chujianlee/git/平衡标定与升降调试指南.md

# 驭风轮足机器人：平衡标定与升降调试指南

固件工程：`D:\download\智能小车项目\robotcat-firmware`
串口：115200，8N1；烧录口随插拔变化（目前是 COM5，CH340）

## 固件结构（2026-10-11 重构后）

原来 800 行全堆在 `main.cpp`，现在按职责拆开：

| 文件 | 职责 |
| --- | --- |
| `src/main.cpp` | 硬件实例定义、`setup()` 初始化、主循环调度、Web/电压检测 |
| `src/balance.cpp` | 平衡环（4 路 P 控制）+ 偏航环 + yaw 角度累加 |
| `src/leg.cpp` | 腿部舵机：车高跟随、滚转补偿、跳跃 |
| `src/wheels.cpp` | 双轮输出合成、速度差同步、倒地/停机保护 |
| `src/diag.cpp` | 串口命令：状态输出、零点标定、双轮测试、参数保存 |
| `src/params.cpp` | 参数持久化（NVS），上电自动加载 |
| `include/robot_config.h` | **所有可调常数集中在这里** |
| `include/robot_state.h` | 跨模块共享的全局状态声明 |

调参只改 `robot_config.h`；运行时优先用 NVS 里保存的值，`W` 保存、`R confirm` 恢复出厂。

---

## 一、为什么现在站不住

对比过官方原版 `Vscode-Shibo-Robot-PIOProj-main`，核心 PID（angle/gyro/distance/speed/yaw）和速度环参数都没被改坏，所以问题不在"参数被改错"，而在下面几件事：

| 症状 | 最可能的原因 | 处理优先级 |
| --- | --- | --- |
| 一放手就往前（或往后）一直加速跑 | **机械零点不对**：`angle_zeropoint=3.4` 是作者那台车的值，你的车装配、电池、轮胎都不同 | 最高，必须先做 |
| 抖得厉害、越纠越倒、发出高频滋滋声 | 主循环太慢，平衡环滞后 | 高（本次已优化） |
| 能站稳但你往前走就往前冲停不住 | 零点偏 + 位置环和推力打架 | 中 |
| 拖高度滑块时直接翻车 | 车高瞬间跳几十个单位，腿一把把车顶倒 | 高（本次已加斜坡） |
| 升高后站不稳 | 重心变高，恢复力矩不够 | 中（本次已加高度自适应） |
| 电机发烫/转不动/一侧不动 | FOC 初始化失败或机械卡滞 | 先看串口 `MOTOR_STATUS` |

---

## 二、本次固件改动（已编译通过）

1. **机械零点可标定、掉电保存**
   - 新增 `Z` 命令：把车扶正、保持静止 2 秒，自动取俯仰角平均值写入零点，并存到 NVS（下次上电自动读取，串口会打印 `ZERO_LOAD angle_zeropoint=...`）。
   - 自动找平漂移与标定零点分离：漂移被限制在 ±1° 以内，不再像原来那样无限漂到 1.4~5.4° 的边界。
2. **舵机总线限频 50Hz**
   - 原来每个主循环都往两个舵机同步写一帧位置（1Mbps 总线 + two I2C），白白吃掉 CPU；现在 20ms 一次，剩下的时间留给 IMU 和 FOC，平衡环比以前跑得快。
3. **车高斜坡：15 单位/秒**
   - 网页滑块一次从 32 拖到 85，现在需要约 3.5 秒慢慢到位，不会瞬移顶翻车身。
   - 升降期间自动：运动指令降额 50%、释放位移零点（允许车自己前后挪一点找重心）。
4. **车高自适应平衡增益**
   - 高度每增加 1 个单位，俯仰和角速度输出提升 0.6%（默认），高重心时回复力矩跟着加大；系数可用 `S` 命令改，`S 0` 关闭。
5. **输出限幅 ±6.5V**
   - 驱动器只有 8V，原来 `LQR_u` 无限幅，倒地瞬间会算出一个巨大的电压，除了让 MOS 发热和车轮暴走没有任何意义。
6. **完整诊断能力**（这是以前最缺的）
   - `P` 打印一次状态，200ms 周期流用 `V 1` 打开、`V 0` 关闭。
   - `T 1.0` 在关闭 Robot Go 的前提下给两个轮子相同电压 1 秒，用来确认两轮转向一致。

---

## 三、串口命令表（115200，发一个字母 + 参数 + 回车）

| 命令 | 作用 |
| --- | --- |
| `Z` | 开始零点标定，2 秒内保持扶正静止，结束打印 `ZERO_CAL done` |
| `Z 3.45` | 手动设定零点并保存 |
| `Zh 0.02` | 设定"零点随车高"的补偿系数（度/单位），默认 0 = 关闭 |
| `P` | 打印一行状态 |
| `V 1` / `V 0` | 打开 / 关闭 200ms 周期状态输出 |
| `T 1.0` | 双轮同压测试 1 秒（**必须先关闭网页上的 Robot Go**） |
| `S 0.006` | 车高增益斜率，默认 0.006，`S 0` 关闭自适应 |
| `W` | **把当前 PID 与零点存进 Flash**（调好必做，否则断电丢失） |
| `R confirm` | 恢复出厂默认参数 |
| `A` `B` `C` `D` | 原有专家 PID：俯仰角 P / 角速度 P / 位移 P / 速度 P |
| `E` `F` | 转向角 P / 转向角速度 P |
| `K` | 腿部滚转补偿 P（左右晃就调它） |

`STATUS` 行字段：
`pitch`（当前俯仰角）、`gyro`（俯仰角速度）、`azp`（当前生效零点）、`u`（最终输出）、
`a/g/d/s`（倾角/角速度/位移/速度 四路分量）、`yawout`（转向输出）、`h`（当前车高）、
`rollout`（腿部滚转输出）、`hz`（主循环频率）、`bat`（电池电压）、`act`（是否使能）。

---

## 四、标准调试流程（严格按顺序）

### 第 0 步：准备
- 电池充满（低于 7.8V 时红灯会灭，此时力矩不够，别调参）。
- **车轮架空**，轮胎离地，手放在电源开关旁。

### 第 1 步：看初始化是否过关
上电后串口应出现：
```
MOTOR_INIT left=motor1 ... MOTOR_INIT right=motor2 ... MOTOR_STATUS left=1 right=1 all=1
```
任一个为 0：先修那一侧的 AS5600 编码器 / 磁铁间距 / 三相线，不要继续调参。

### 第 2 步：确认两个轮子转同一方向
网页保持 Robot Go 关闭，串口发：
```
T 1.0
```
1 秒内观察 `WHEEL_SPEED left=... right=...`：两个值必须**同号**。一正一负说明电机相线或编码器方向反了，交换该轮任意两相或在 `motor.linkSensor` 后调整方向，不要用 PID 去掩盖。

### 第 3 步：标定机械零点（最关键）
把车用手扶到真正竖直的位置，保持稳定不动，串口发：
```
Z
```
保持 2 秒，串口返回 `ZERO_CAL done angle_zeropoint=x.xxx saved`，这个值会自动保存。
用完 `V 1` 打开状态流，静置时 `pitch` 应该基本等于 `azp`，两者差在 ±0.3° 内。

### 第 4 步：架空试站
网页勾选 Robot Go，车应能在原地保持。
- 若车有回正趋势但力度不足 → 略增 `A`（如 `A 1.2`）。
- 若高频抖动/滋滋声 → 增 `B`（阻尼，`B 0.08`），不要乱加 A。
- `hz` 低于 150 说明循环太慢，先不要再调 PID，检查串口打印是否太频繁（关掉 `V 0`）。

### 第 5 步：落地，再确认零点
落地后如果依然缓慢向一个方向移动，看 `STATUS` 里 `d`（位移分量）：
长期偏向某个符号且不归零，把零点按符号微调（车往前跑就把零点加大一点点）：
```
Z 3.52
```
每次改 0.05~0.15，改一次测一次。

### 第 6 步：前进 / 后退 / 左右
摇杆短促点动，看 `a/g/d/s` 四个分量：正常情况下前进只让 `s` 明显变化，`a` 不应持续同号饱和。
转向不够灵敏调 `E`，转过头回摆调 `F`。

### 第 7 步：升降（就是你说的"升轴"）
先确认第 6 步已稳，然后**每次只拖 5~8 个单位**（网页滑块 32~85），等车稳了再继续。
- 升高过程中如果车身开始前后大幅摆动：把 `S` 提高（`S 0.010`），让高重心时的恢复力度更大。
- 如果升高到某高度后总是慢慢往一个方向走：说明零点随车高有系统偏移，加一点 `Zh`：
  ```
  Zh 0.01
  ```
  往哪边走就用正负号修正（往前走取负值，往后走取正值），每次 0.005。
- 左右晃（roll）用 `K`（腿部滚转 P），默认 4；抖就降，压不住就加。

---

## 五、电源与电池

### 5.0【最重要】主板本身不具备充电功能

从 `2.Hardware\ProPrj_轮腿机器人-世博同学-正式版.epro`（立创EDA 工程）原理图提取出的**全部**芯片清单：

| 型号 | 用途 |
| --- | --- |
| MP2225GJ | DC-DC 降压 |
| XC6210B332MR | 3.3V LDO |
| CH340C | USB 转串口 |
| AS5600 | 磁编码器 |
| SS8050 / SS8550 | 三极管 |
| HX25003 / WJ126V / CC225131 | 接线端子、插座 |

**没有任何充电管理芯片**。在原理图里搜索 `TP4056`、`TP5100`、`MCP738xx`、`BQ24xxx`、`IP2312`、`CN3163`、`CN3058`、`IP5306`、`SY69xx`、`CHARGE`、`CHRG`，**全部 0 命中**。

> **结论：USB-C 口只负责「供电 + 烧录 + 串口」，从来没有给电池充电的能力。这是设计，不是故障。**
> 不要指望插着 USB 过一夜电池会满。

### 5.1 正确的充电方式（必须用外接充电器）

配套资料原文：
- docx：「新电池使用前先充电，**默认搭配的充电器是 B3**，三个灯都变成绿色（黄色）即为充满」
- PDF：「默认搭配的充电器是 B3」

航模 2S 电池上**有两根线，别搞混**：

| 线 | 插头 | 接到哪里 |
| --- | --- | --- |
| **粗的红黑两根** | XH2.54 白色插头 | **放电口** → 插主板给车供电 |
| **细的白色多针** | JST-XH 平衡头（3 针） | **充电口** → 插 B3 充电器充电 |

**正确顺序是：先用 B3 把电池充满 → 再把粗线插头插到主板。**
不是「插USB让车充电」。顺序反了就会卡在这里。

### 5.2 怎么知道电池有没有电

在插着 USB 的情况下串口发 `P`，看 `bat=`：

| `bat=` 读数 | 含义 |
| --- | --- |
| `3.4 ~ 3.7` | 电池没接上，或完全没电（此时只有 USB 供电） |
| `6.0 ~ 7.8` | 接上了但亏电，蓝灯**不会**亮 |
| `7.8 以上` | 电量充足，蓝灯亮（GPIO13 阈值 7.8V） |

### 现象
只插 USB-C 能跑，拔掉就断电；板上只亮红灯不亮蓝灯。串口一直报：
```
BAT_LOW voltage=3.56V (<6.0V): no battery or nearly empty; output limited to 3.0V
```
`bat` 只有 3.5V 左右 —— 这是 USB 经板内降压后 ADC 读到的电压，**说明电池回路根本没接通**（2S 电池满电应为 7.4~8.4V）。

### 原理：红灯 ≠ 电池已接
- **红灯** = 板子通电（USB 也能点亮它），不代表电池接上了。
- **蓝灯**（GPIO13）由固件控制，只有 `bat > 7.8V` 才会亮 —— 它才是"电池已接且电量足"的标志。

### 用固件当电压表定位（不用万用表、不用看图）
固件会在电池接入/拔出的瞬间各播报一次，所以可以逐个接口试：

1. **保持 USB 插着**（不然没串口），串口助手打开 115200。
2. 确认主控板上的**电源拨动开关**已拨到 ON（参考文档原文：「并打开主控板开关供电」）。
3. 把电池的 XH2.54 白色插头插到板上候选的 2pin/3pin 白色插座之一。
4. 串口立刻会出现二者之一：
   - `BAT_OK voltage=7.xxV  <- this is the battery port!` → **就是这个口**，记下位置。
   - 仍然 `bat=3.5x` / 播 `BAT_LOW` → 换下一个插座再试。
5. 拔掉电池时会播 `BAT_GONE`，可用来交叉确认。

> 配套 docx 原文写的是「将插头接入**中间接口**」，GitHub README_CN 写的是主控板**后侧**接口。
> 两个说法指的可能就是同一个位置，但以**上面实测电压跳变**为准，最可靠。

### 排查顺序
| 检查项 | 说明 |
| --- | --- |
| 电池是否有电 | B3 充电器充到三个灯全绿；低于 7.8V 蓝灯不亮且力矩不够 |
| 电源开关是否打开 | 主控板上有拨动开关，出厂可能是 OFF |
| 插头型号 | 航模 2S 电池配 XH2.54 插头，别硬插到舵机 3pin 口上 |
| 线序/极性 | 反接会烧板子；插之前确认红对红、黑对黑 |
| 电池是否插 BB 响 | 长期存放插着 BB 响会耗光 |

---

## 六、安全规则（照做）

- 任何时候车轮转速异常、车身猛烈摆动、电机快速发热 → 立即断电。
- 随身保持一只手在电源开关上。
- 标定零点、双轮测试、固件烧录时，车轮架空或断电。
- **一次只改一组参数**，改完编译 → 上传 → 复测，不要同时改几组（改了不知道是哪一组生效）。

## 七、编译与上传

```powershell
cd D:\download\智能小车项目\robotcat-firmware
C:\Users\HP\.platformio\penv\Scripts\pio.exe run
C:\Users\HP\.platformio\penv\Scripts\pio.exe run -t upload --upload-port COM5
```
上传前关闭所有串口监视器占用该端口的程序（VSCode 串口、ATK-XCOM 等串口助手），
否则会报 `PermissionError(13) 拒绝访问`。

---
更新时间：2026-10-11 · 适用固件：模块化重构后的当前版本
