chujianlee/git/驭风轮足机器人-快速学习Skill.md

# 驭风轮足机器人：快速学习 Skill

这是一份给新成员的快速上手文档。项目是 ESP32 主控的双轮足自平衡机器人：无刷电机负责轮子和移动，MPU6050 测姿态，AS5600 测轮子角度，STS3032 舵机负责腿部动作，网页通过 WiFi 控制。

## 一、先认识项目

- `1.RobotModel`：3D 打印、CNC、碳纤维结构件
- `2.Hardware`：主控板、编码器板、舵机调试板和 PCB 文件
- `3.Software`：Arduino 版和 VSCode + PlatformIO 版固件
- `4.配套软件资料`：舵机调试软件 FD.exe 与 STS3032 资料
- `世博同学-驭风轮足机器人入门指导1215.pdf`：完整装配与调试说明

推荐使用 VSCode + PlatformIO 版。当前维护的工程路径为：

`D:\download\智能小车项目\robotcat-firmware`

## 二、控制链路

浏览器网页发送 JSON 控制量给 ESP32。`joy_x` 是左右转向，`joy_y` 是前后移动，`stable` 是站立/平衡开关。ESP32 读取 MPU6050 和两个 AS5600，通过 PID/LQR 计算两个电机目标，再由 SimpleFOC 驱动无刷电机。

## 三、第一次上电

1. 上电前检查 7.4V 电池、5V、3.3V，确认没有短路。
2. 小车先架空，轮子不要接触地面。
3. 等初始化完成：红灯、轮子微动、腿部动作，最后进入可控制状态。
4. 手机或电脑连接机器人热点。当前固件实测为：
   - WiFi：`WLROBOT-TD`
   - 密码：`wlrobot123`
   - 网页：`http://192.168.1.11/`
5. 网页点击站立后，先短按左右和前后测试，再落地。

## 四、烧录固件

1. 用 USB 连接主控板，设备通常显示为 `USB-SERIAL CH340`。
2. COM 口可能在 COM3 和 COM4 间变化，选择设备管理器中状态正常的端口。
3. 在工程目录执行：

```powershell
pio run
pio run -t upload --upload-port COM3
```

如果端口被占用，关闭串口监视器、VSCode 其他串口窗口后重试。当前中文路径主工程已经编译通过；遇到具体路径兼容错误再考虑使用英文路径副本。

## 五、平衡与运动调参

关键文件是 `src/main.cpp` 和 `src/robot.cpp`。

- `angle_zeropoint`：每台车不同的机械平衡零点，需要扶正后实测。
- `pid_angle`、`pid_gyro`：前后俯仰平衡。
- `pid_roll_angle`：左右滚转补偿。
- `YAW_angle_total`：左右转向目标。
- `joy_y`：前后指令；当前固件已限制到 `-50..50`，降低后退过猛倒车风险。
- `wheel_sync_kp`、`wheel_sync_ki`、`wheel_sync_limit`：双 AS5600 速度差同步补偿参数；直行时修正左右机械差异，转弯时自动降低作用。

架空调试时可在 115200 串口查看 `WHEEL_SPEED left=... right=... error=... sync=... active=... weight=... integral=...`。`left/right` 是编码器实测速度，`error` 是滤波后的差值，`sync` 是当前补偿量。某侧为零或初始化失败时先排查硬件，不要靠提高同步增益解决。

当前保守初值：`pid_roll_angle(4, 0, 0, 100000, 250)` 控制腿部舵机；转向按 `turn_command * 0.3f * control_dt` 累计，不再使用旧每循环 `0.0005` 系数。同步补偿参数尚未实车标定，每次只改一组参数，编译、上传后先架空测试。

### 零点标定与升降（抬高"轴"）稳定（2026-10-10 新增）

详细流程见 `D:\download\智能小车项目\平衡标定与升降调试指南.md`。

串口 115200 新增命令：`Z` 自动标定机械零点并存入 NVS、`Z 3.45` 手动设定、`Zh 0.02` 零点随车高补偿、`P` 打印状态、`V 1/0` 周期诊断、`T 1.0` 双轮同压转向测试（须先关闭 Robot Go）、`S 0.006` 车高增益斜率。

固件其他改动：舵机同步写限频 50Hz（腾出时间给 IMU/FOC）、车高斜坡 15 单位/秒防止滑块突变顶翻、升降期间释放位移零点并把运动指令降额到 50%、`LQR_u` 限幅 ±6.5V、自动找平漂移限制 ±1°。

上车顺序固定为：架空 → 看 `MOTOR_STATUS left=1 right=1 all=1` → `T` 确认双轮同向 → `Z` 标定零点 → 勾选 Robot Go 试站 → 落地微调 → 最后才玩升降。

### 固件框架重构（2026-10-11）

原来的 800 行单体 `main.cpp` 已按职责拆开，调参不再需要翻代码：

| 文件 | 职责 |
| --- | --- |
| `src/main.cpp` | 硬件实例、`setup()`、主循环调度、Web、电压检测 |
| `src/balance.cpp` | 平衡环（4 路 P 控制）+ 偏航环 |
| `src/leg.cpp` | 腿部舵机：车高跟随、滚转补偿、跳跃 |
| `src/wheels.cpp` | 双轮输出合成、速度差同步、倒地/停机保护 |
| `src/diag.cpp` | 串口命令（Z/P/V/T/S/W/R） |
| `src/params.cpp` | 参数持久化（NVS，上电自动加载） |
| `include/robot_config.h` | **全部可调常数**，`namespace cfg` |
| `include/robot_state.h` | 跨模块共享状态声明 |

新增两条命令：`W` 把当前 PID 与零点存进 Flash（调好必做）、`R confirm` 恢复出厂。
新增低压保护：`bat < 6.0V` 时输出上限从 6.5V 降到 3.0V，避免只插 USB 时满转矩暴走。

## 六、常见故障

### 只插 USB 能动，拔掉 USB 就断电（电池没接通）

串口会一直播 `BAT_LOW voltage=3.5xV (<6.0V)`。`bat` 只有 3.5V 是 USB 经板内降压后的读数，2S 电池应为 7.4~8.4V。

**红灯亮 ≠ 电池接上了**：红灯只表示板子通电（USB 也能点亮）。蓝灯（GPIO13）由固件在 `bat > 7.8V` 时点亮，才是"电池已接且电量足"。

定位办法（不用万用表、不用看图）：保持 USB 插着，串口打开，把电池 XH2.54 插头依次插到板上各白色插座，看串口是否出现
`BAT_OK voltage=7.xxV <- this is the battery port!`。仍然 `bat=3.5x` 就换下一个。拔掉时播 `BAT_GONE`。

注意：主控板上有 **电源拨动开关**，先确认拨到 ON。配套 docx 原文写「将插头接入中间接口」，GitHub README_CN 写「后侧接口」，两者冲突，以上面实测电压跳变为准。

### 网页打不开

确认已连接 `WLROBOT-TD`，不要使用旧地址 `192.168.4.1`；当前地址是 `192.168.1.11`。若热点消失，检查电池供电、按 EN 复位，并等待初始化。

### 上电后不能平衡

先架空测试；检查电池电压、腿部机械位置、MPU6050 安装方向、编码器磁铁是否对准。不要直接提高 PID。

### 两个轮子转速不一致

优先检查左右电机插头、编码器线、AS5600 磁铁和编码器板。串口日志中的 `PPcheck`、`sensor_direction`、`Zeroelec.angle` 可帮助判断编码器和方向。

若一个轮子持续转、另一个完全不转，先查看串口的 `MOTOR_STATUS left=... right=... all=...`。`right=0` 表示右轮 FOC 初始化未通过；停止反复发送运动指令，检查右侧 AS5600 编码器/I2C、磁铁间距、电机三相线及驱动器供电。当前工程已增加保护：任一轮 `initFOC()` 失败会同时禁用两个电机，避免单轮继续旋转。若 `right=1` 仍不转，再查驱动输出、机械卡滞和电机本体；这类故障不能通过调平衡 PID 解决。

2026-10-10 双轮速度同步最终版在主工程和 VS Code 副本编译成功，并已用 COM4 烧录；上传日志确认 ESP32 固件写入和 Hash 校验通过。被动读取串口时新轮速日志持续输出，控制处于关闭状态。尚未完成双轮运行速度差测量与实车平衡复测；架空测试先看串口确认 `left=1 right=1 all=1`，然后再低幅度短按前进。

## VS Code 看不到烧录键

打开包含 `platformio.ini` 的工程根目录 `D:\download\智能小车项目\robotcat-firmware`。如果小蚂蚁侧栏显示 `Initializing PlatformIO Core...`，按 `Ctrl+Shift+P` 执行 `Developer: Reload Window`，因为安装器提示必须重启 VS Code。重载后进入 `Project Tasks` → `esp32dev` → `General` → `Upload`。也可以在 VS Code 终端运行：

```powershell
pio run -t upload --upload-port COM4
```

### 舵机不动作

使用 FD.exe，波特率 `1000000`；左舵机 ID 通常为 1，右舵机 ID 通常为 2。一次只调试一个舵机，先确认供电。

## 七、安全规则

- 电池供电时旁边放手在电源开关处。
- 架空测试只做短促、低幅度输入。
- 轮子转速异常、车身猛烈摆动或电机发热时立即断电。
- 电机方向、编码器和机械零点没有确认前，不要让小车高速落地运行。

## 八、学习顺序

按“看原理 → 认硬件 → 架空上电 → WiFi 网页 → 烧录固件 → 编码器/舵机标定 → 平衡调参 → 低速落地”学习。先理解每个模块的输入输出，再修改参数。

对应资料：

- `D:\download\智能小车项目\世博同学-驭风轮足机器人入门指导1215.pdf`
- `D:\download\智能小车项目\调试教程-readme2.0.docx`
- `C:\Users\HP\.codex\skills\robotcat\SKILL.md`
