chujianlee/git/1.RobotModel/1.3D打印（建议尼龙烧结）/说明.txt

磁铁套 建议FDM打印
剩下的建议尼龙烧结
ColumnCover x2，Hub x2 这两个文件单套需要2个
