chujianlee/git/1.RobotModel/2.CNC相关（建议铝合金）/1.BodyBaseNew-螺纹信息.jpg

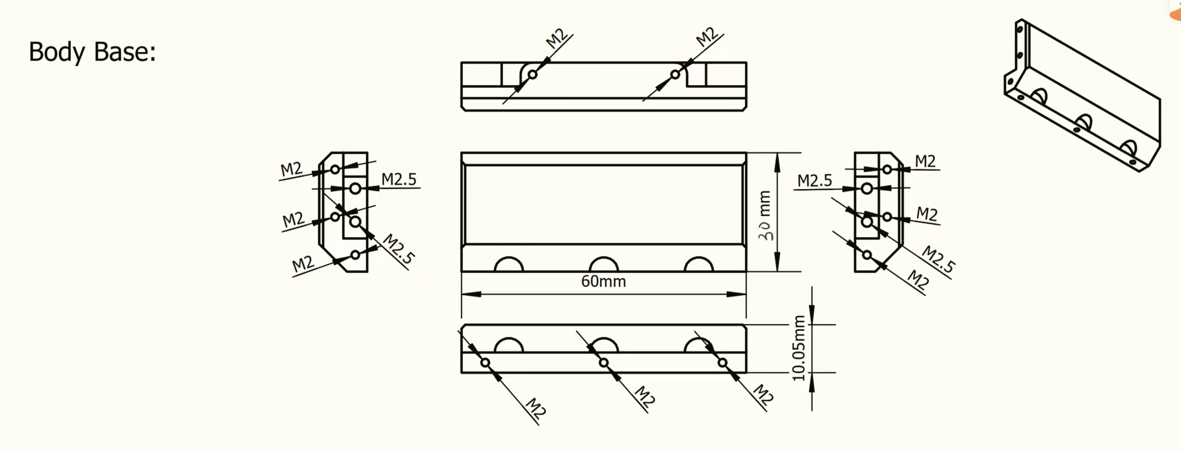
1.RobotModel/2.CNC相关（建议铝合金）/1.BodyBaseNew-螺纹信息.jpg
