chujianlee/git/1.RobotModel/2.CNC相关（建议铝合金）/2.MotorBase-Aluminum6061-螺纹信息.png

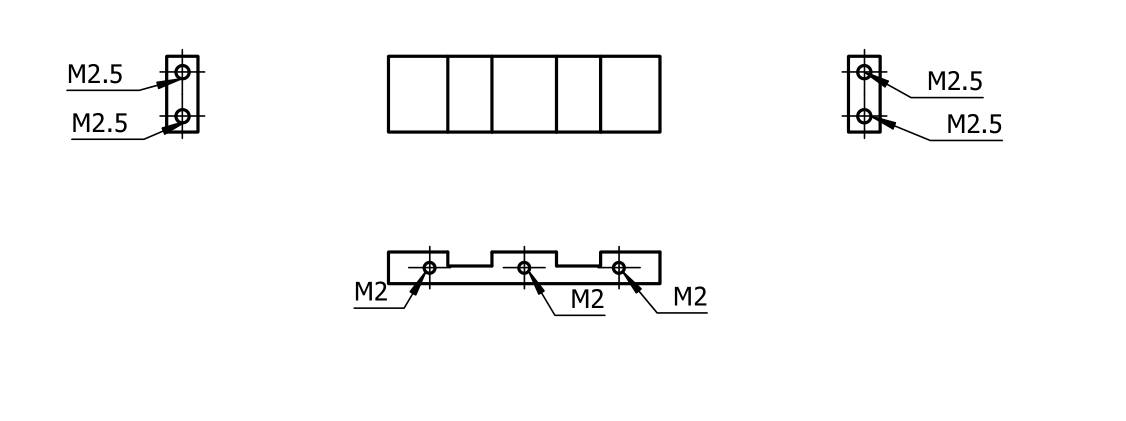
1.RobotModel/2.CNC相关（建议铝合金）/2.MotorBase-Aluminum6061-螺纹信息.png
