chujianlee/git/1.RobotModel/1.3D打印（建议尼龙烧结）/大腿-1.stl

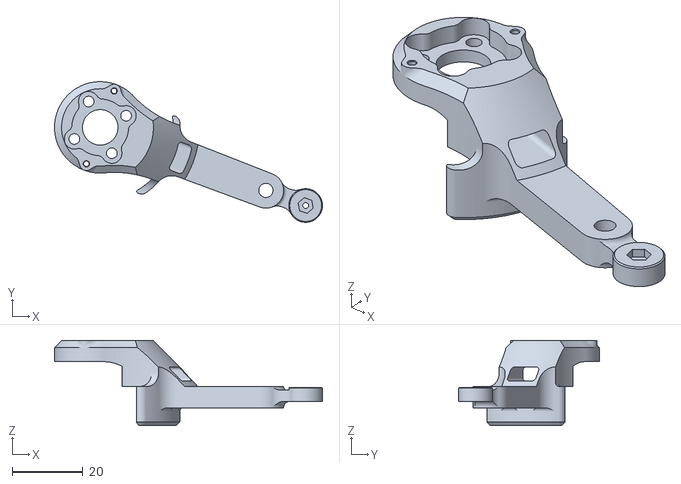
[picture p41: CAD file, 2026-10-12]
1.RobotModel/1.3D打印（建议尼龙烧结）/大腿-1.stl
75.6 x 39.7 x 24.0
