chujianlee/git/1.RobotModel/2.CNC相关（建议铝合金）/2.MotorBase-Aluminum6061.STEP

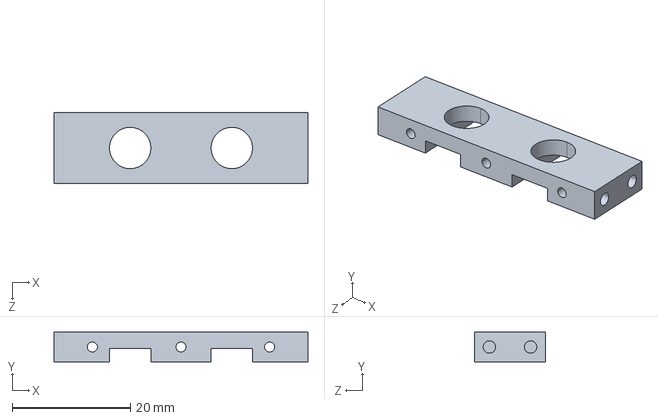
[picture p42: CAD file, 2026-10-12]
1.RobotModel/2.CNC相关（建议铝合金）/2.MotorBase-Aluminum6061.STEP
43.0 x 5.00 x 12.0 mm
