chujianlee/git/4.配套软件资料/4.配套软件资料/舵机相关/官方资料-STS3032舵机调试资料/STS3032舵机调试资料/STS3032舵机调试资料/STS3032 图纸3D.stp

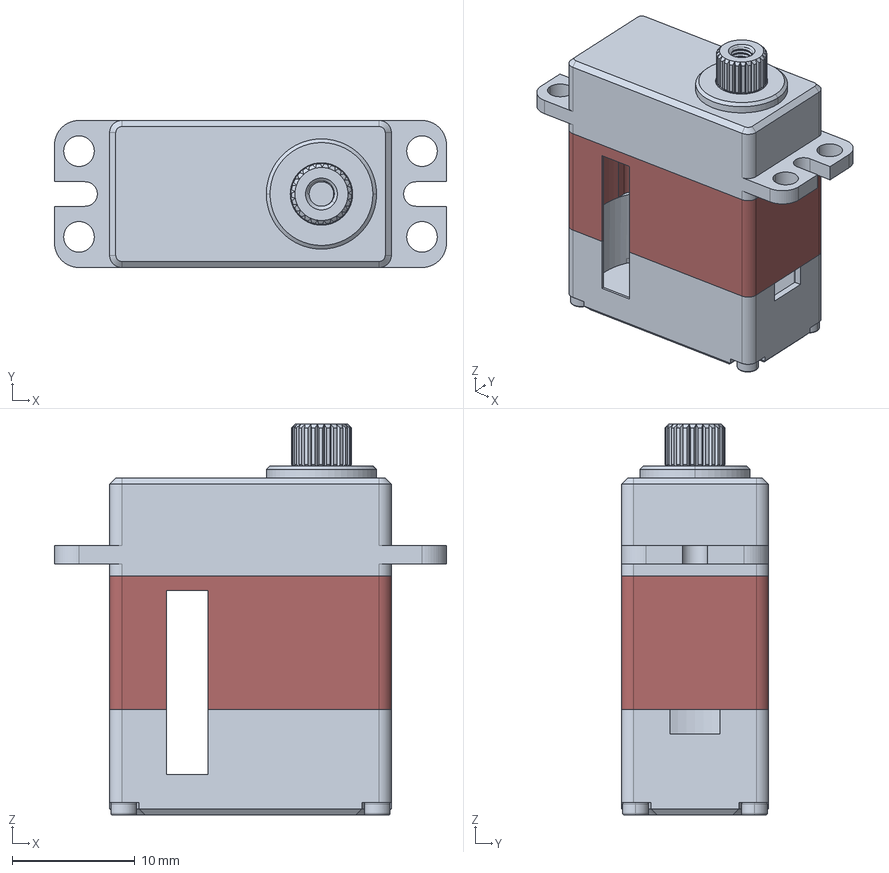
[picture p43: CAD file, 2026-10-12]
4.配套软件资料/4.配套软件资料/舵机相关/官方资料-STS3032舵机调试资料/STS3032舵机调试资料/STS3032舵机调试资料/STS3032 图纸3D.stp
32.0 x 12.0 x 31.9 mm
WJ-WK00-0024_47
WJ-WK00-0023_33_1
WJ-WK00-0025_13
PB13-23-M_5 x 4
