chujianlee/git/1.RobotModel/1.3D打印（建议尼龙烧结）/磁铁套X2.STEP

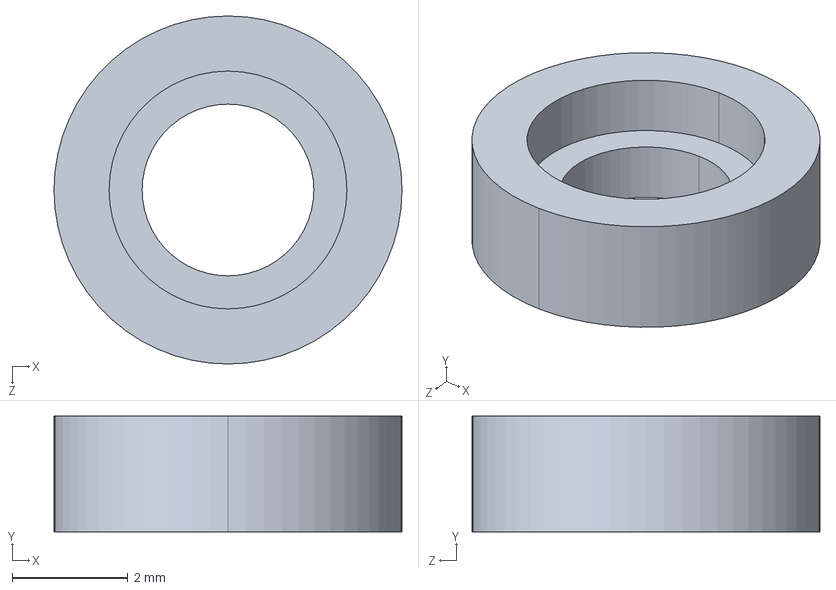
[picture p44: CAD file, 2026-10-12]
1.RobotModel/1.3D打印（建议尼龙烧结）/磁铁套X2.STEP
6.00 x 2.00 x 6.00 mm
