chujianlee/git/1.RobotModel/2.CNC相关（建议铝合金）/1.BodyBaseNew.STEP

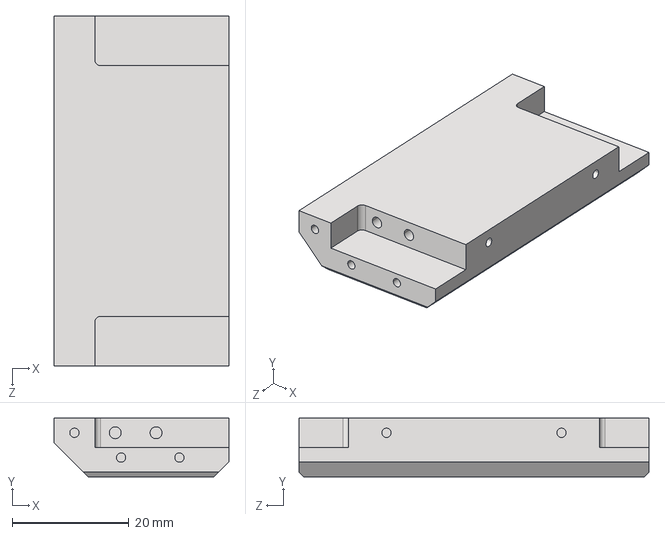
[picture p45: CAD file, 2026-10-12]
1.RobotModel/2.CNC相关（建议铝合金）/1.BodyBaseNew.STEP
30.0 x 10.1 x 60.0 mm
