chujianlee/git/(list of files, cad)

Other CAD files:
1.RobotModel/3.碳纤维切割/Panel-250112.dwg
1.RobotModel/1.3D打印（建议尼龙烧结）/大腿--2.stl
1.RobotModel/2.CNC相关（建议铝合金）/1.BodyBaseNew.SLDPRT
1.RobotModel/2.CNC相关（建议铝合金）/2.MotorBase-Aluminum6061.SLDPRT
