chujianlee/git/4.配套软件资料/舵机相关/官方资料-STS3032舵机调试资料/说明.docx

STS3032舵机的调试资料和软件下载连接，一些代码示例也是可以在链接上面下载参考的

https://gitee.com/ftservo

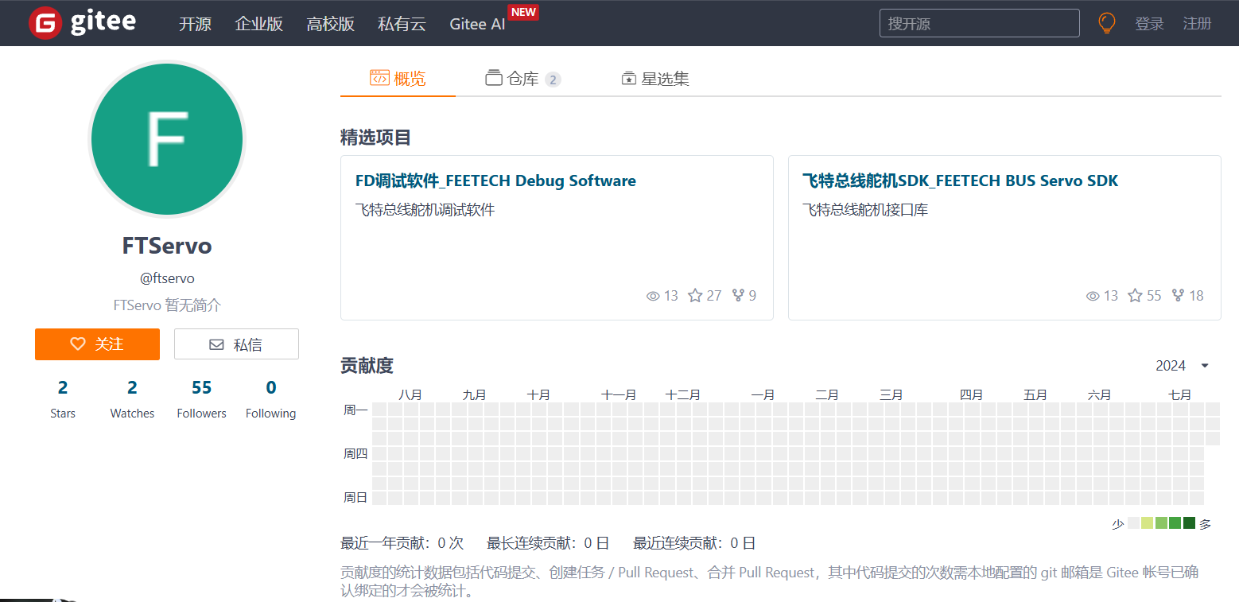
[picture p70: figure]
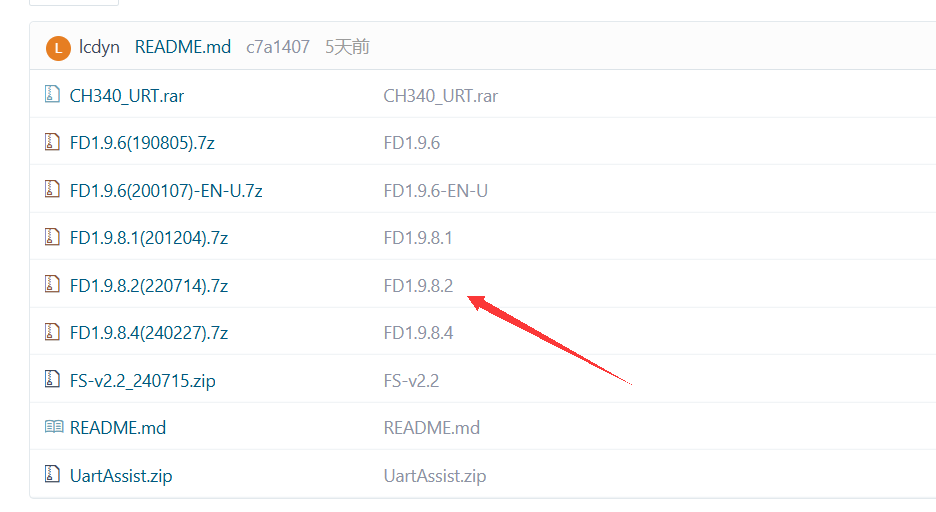
[picture p71: figure]
