chujianlee/git/4.配套软件资料/舵机相关/官方资料-STS3032舵机调试资料/STS3032舵机调试资料/STS3032舵机调试资料/FD Software.docx

https://gitee.com/ftservo

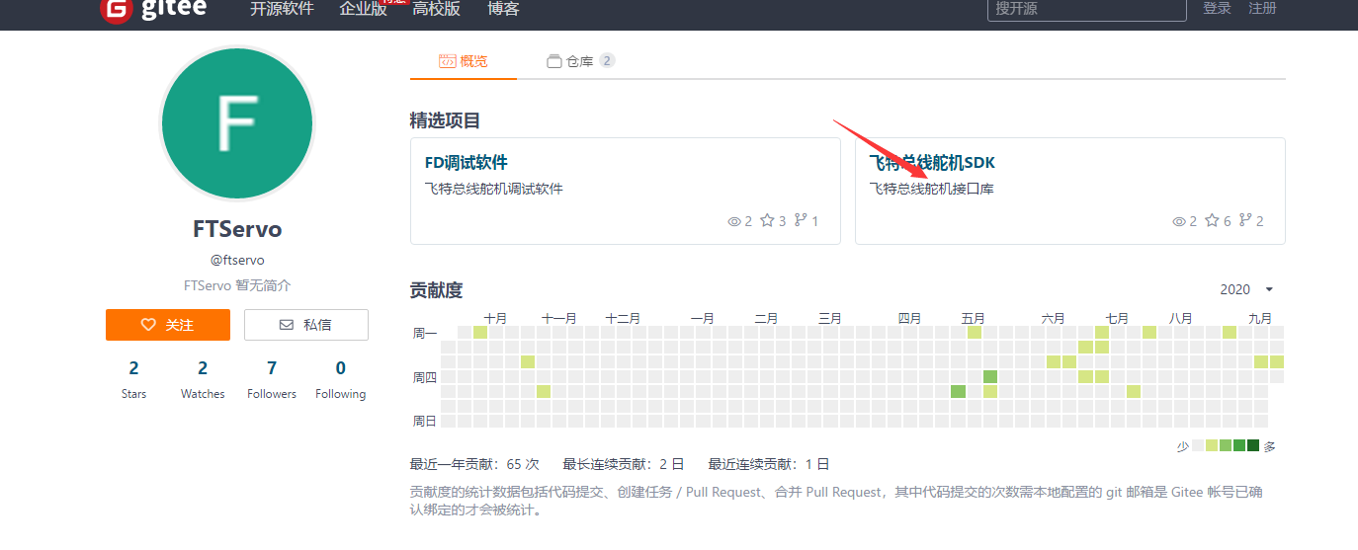
[picture p72: figure]
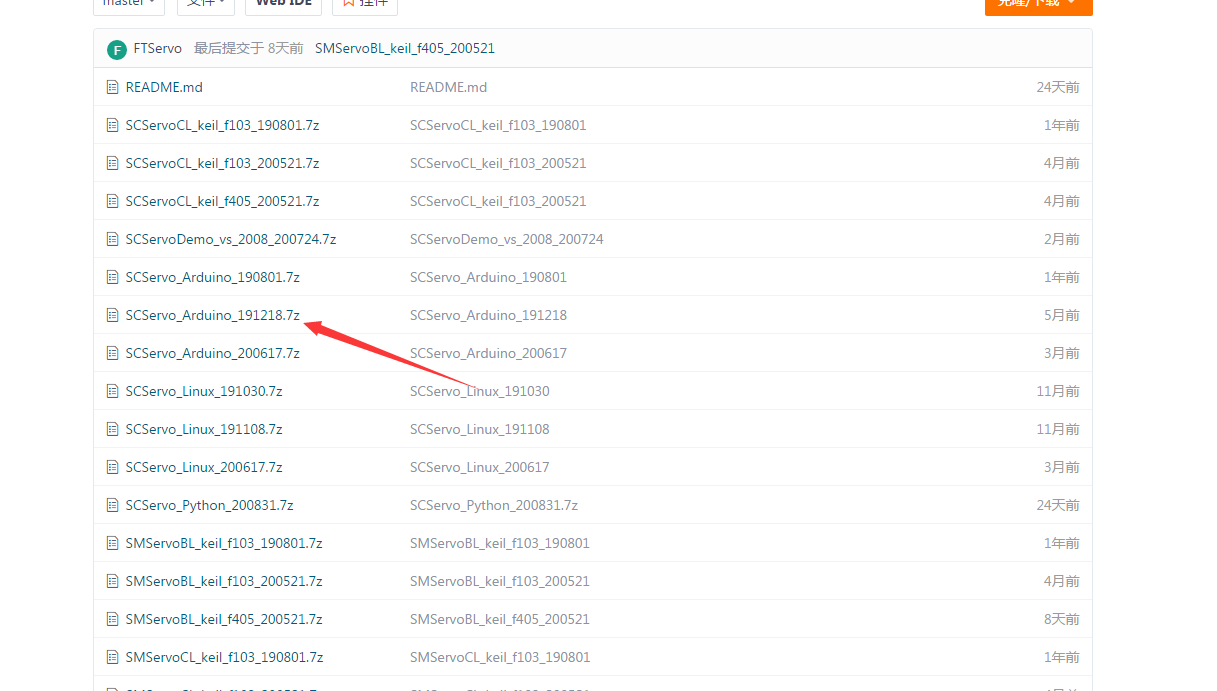
[picture p73: figure]
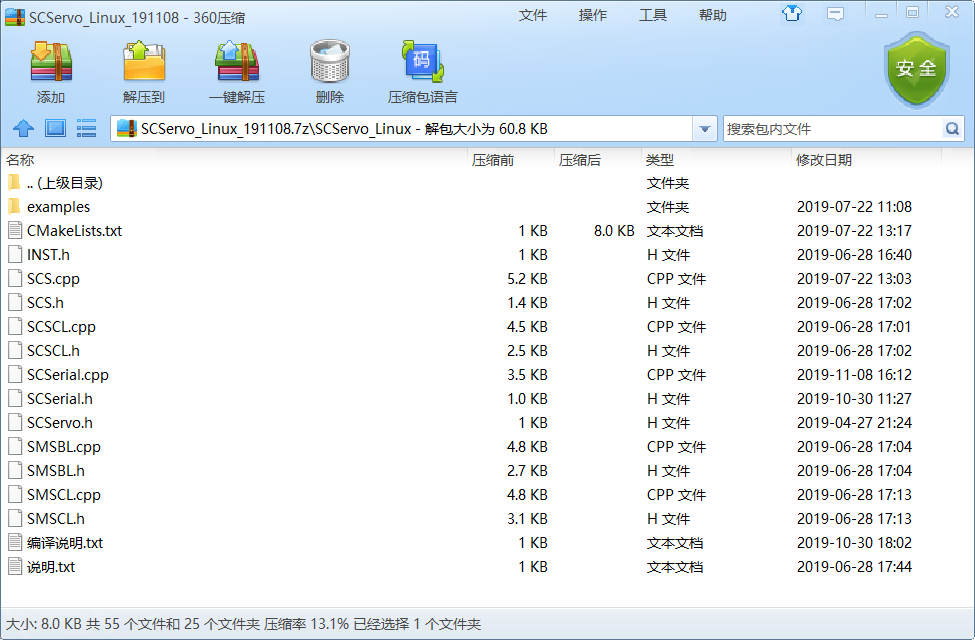
[picture p74: figure]
70240f978cfb666444bc936da65a487
