chujianlee/git/4.配套软件资料/舵机相关/官方资料-STS3032舵机调试资料/STS3032舵机调试资料/STS3032舵机调试资料/WJ-DP00-0004-舵盘 18X4.5MM-小25T-20201230.pdf.pdf

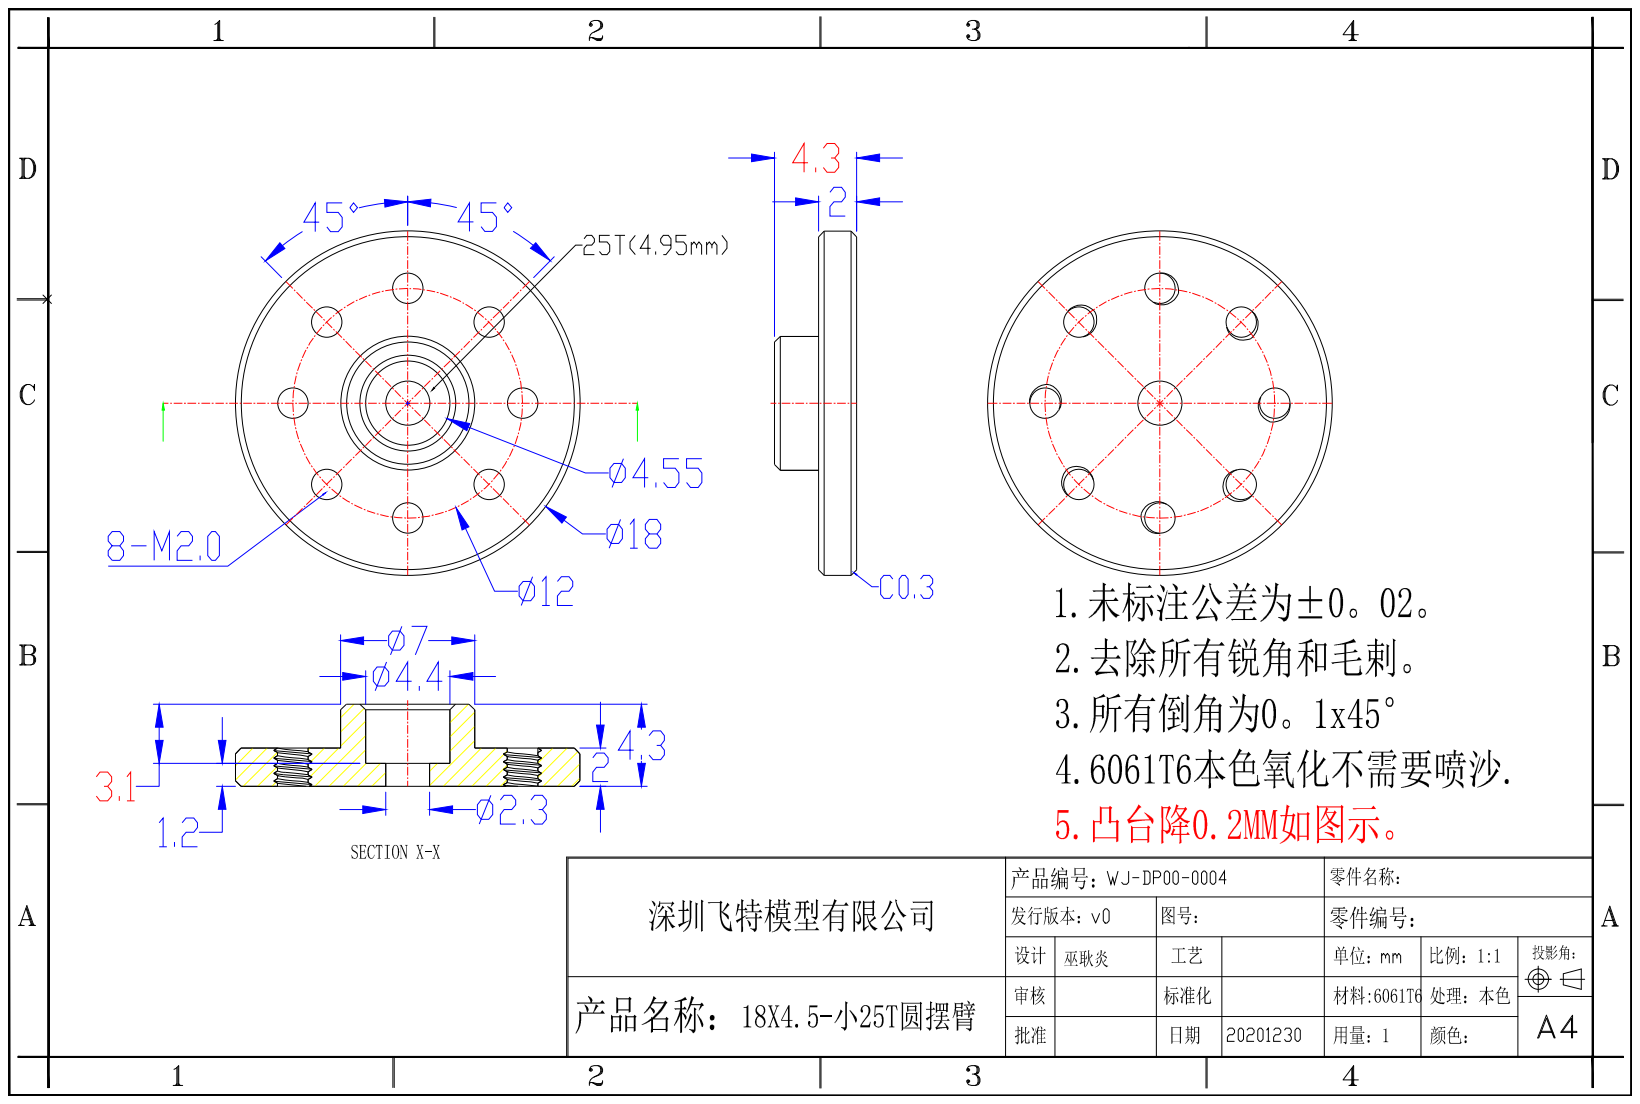
[picture p75: page 1]
