chujianlee/git/(list of files, drawings)

Other design files:
2.Hardware/ProPrj_轮腿机器人-世博同学-正式版.epro
